JhonyRetro/fbp/docs/trapezoid-waveform.png

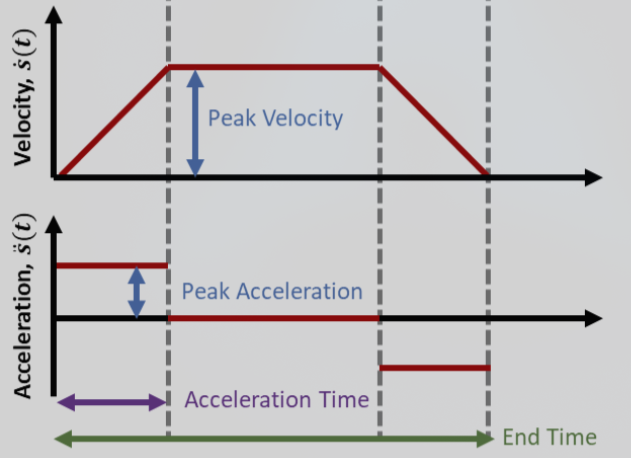
docs/trapezoid-waveform.png
