JhonyRetro/fbp/docs/packet-test1.png

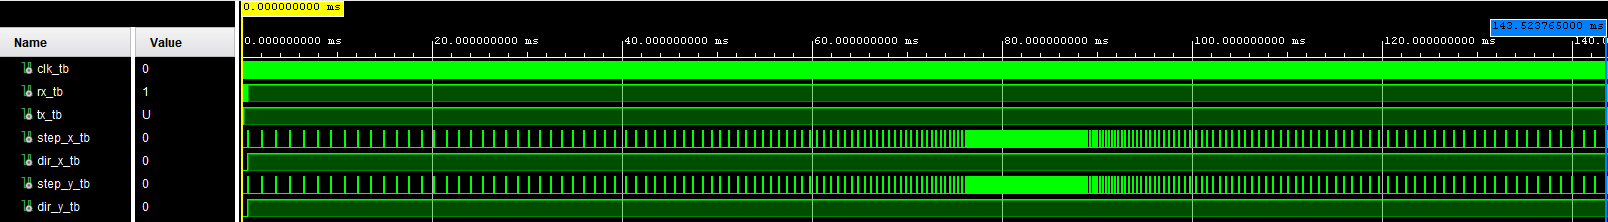
docs/packet-test1.png
