JhonyRetro/fbp/docs/packet-test4.png

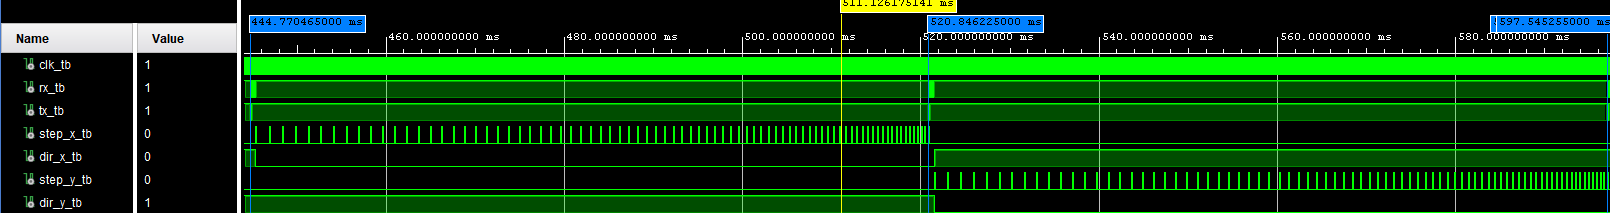
docs/packet-test4.png
