JhonyRetro/fbp/docs/impl_schematic.pdf

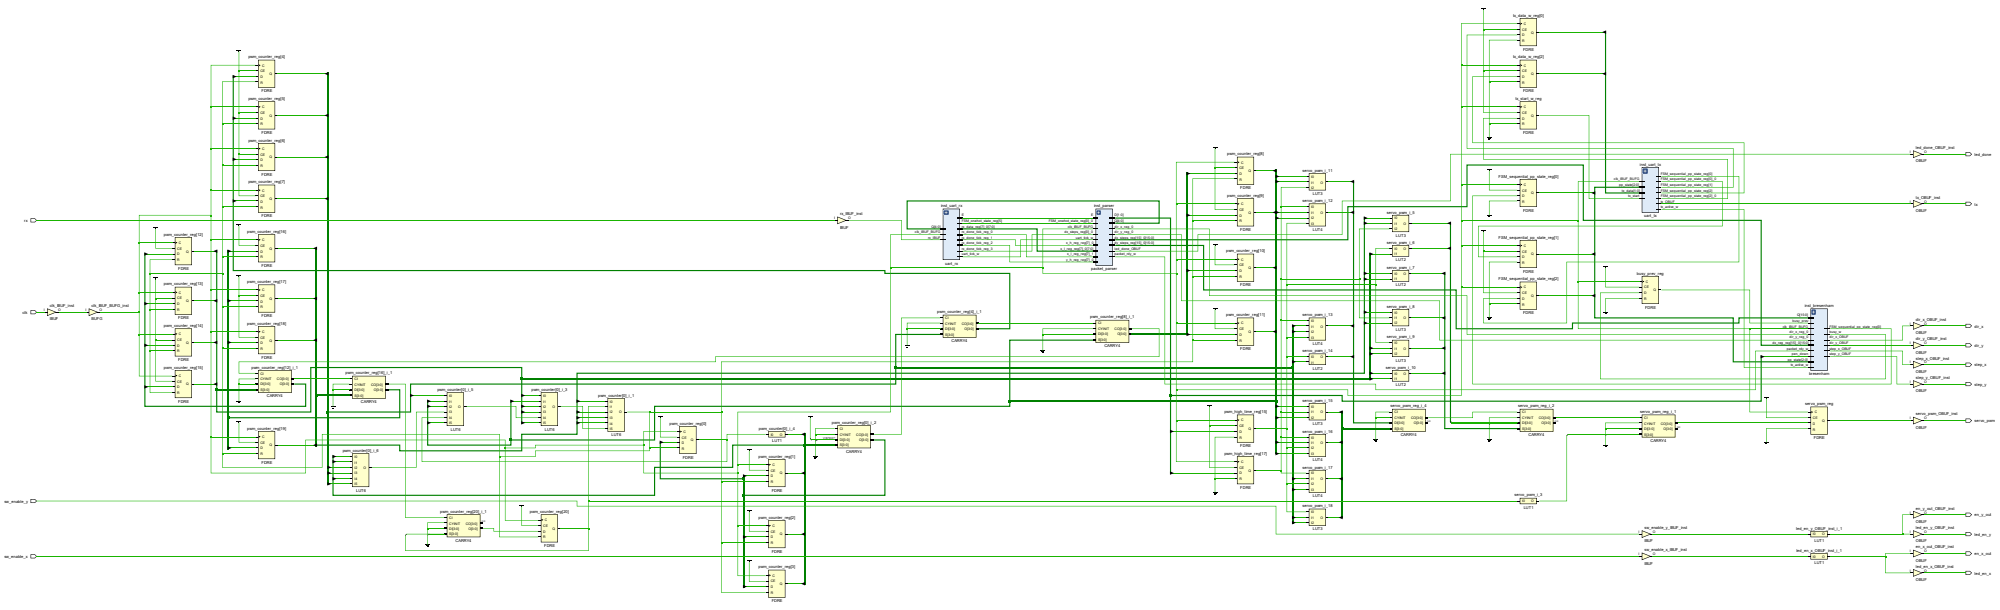
[picture p12: page 1]
rx clk sw_enable_y sw_enable_x; clk_IBUF_inst IBUF; clk_IBUF_BUFG_inst BUFG; pwm_counter_reg[12] FDREQ; CCED; R pwm_counter_reg[13] FDREQ; R pwm_counter_reg[14] FDREQ; R pwm_counter_reg[15] FDREQ; R pwm_counter_reg[4] FDREQ; R pwm_counter_reg[5] FDREQ; R pwm_counter_reg[6] FDREQ; R pwm_counter_reg[7] FDREQ; R pwm_counter_reg[16] FDREQ; R pwm_counter_reg[17] FDREQ; R pwm_counter_reg[18] FDREQ; R pwm_counter_reg[12]_i_1 CARRY4 CI CYINIT; O[3:0] S[3:0] pwm_counter_reg[19] FDREQ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
