JhonyRetro/fbp/(commit log)

2026-05-08 feat: fpga uart communication
2026-05-08 docs: fbp electrical circuit
2026-05-09 feat: bresenham algorithm error acc fsm
    [bresenham.vhd, bresenham_testbench.vhd]
2026-05-09 build: pin enabling
2026-05-09 feat: uart tx module
2026-05-09 build: pin remap
2026-05-10 fix: pin mapping and typos
    [Basys3_Master.xdc]
2026-05-11 docs: adjust circuit diagram
2026-05-11 docs: final circuit version
2026-05-11 refactor: delete limit switch signals (future feat)
2026-05-15 docs: fix schematics
